fTomo-robot/Robotrace/(commit log)

2026-07-05 githubにあげる
    [DC-DC.kicad_sch, IMU.kicad_sch, MD.kicad_sch, Robotrace.kicad_pcb, Robotrace.kicad_sch]
2026-07-06 STM32のGPIOにUSB/UART/SPI/ADCの配線を追加、J11にラインセンサーを接続
    MCUのPA9-PA12(UART/USB), PB12-15(SPI)と、ADC用にPA0-7/PB0-1/PC0-3をラインセンサー13本+電圧監視1本に割り当て、J11コネクタのPin1-13にもラインセンサーの配線を追加。あわせてLineシートとCD74HC4067ライブラリを取り込み。
    Claude-Session: https://claude.ai/code/session_01781fWTRjWjmRZVNFFPgVZP
    [Line.kicad_sch, Robotrace.kicad_sch]
2026-07-06 モーターPWM/エンコーダ配線とST-LINK(SWD)配線を追加、J11欠落を修正
    PA8/PB8/PB9/PC9をPWM_A_L/B_L/A_R/B_Rに、PB4/PB5/PC6/PC7をEnc_A_L/B_L/A_R/B_Rに割り当てて配線。PA13/PA14/PB3をSWDIO/SWCLK/SWOラベルに接続しST-LINK経由のデバッグを可能に(NRSTは既存のRSTラベル経由で接続済みだったため対応不要)。
    また前回のトラブル対応(git checkout)で誤って失われていたJ11コネクタの復旧を反映(ユーザーがKiCad上で再配線)。
    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
    [Robotrace.kicad_sch]
2026-07-06 サイドセンサ・MDのEN・ビープ・LED・スイッチをMCUに配線
    PA15->LED_1, PB2->LED_2, PB6->LED_3, PB10->LED_4, PB11->SW_1, PC8->SW_2,
    PC10->MD_EN(2基のモータードライバ共通イネーブル), PC11->Side_L, PC12->Side_R, PC13->beep を割り当て。
    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
    [Robotrace.kicad_sch]
2026-07-06 ビープをPWM出力可能なPB11(TIM2_CH4)に変更、SW_1はPC13に移動
    PC13にはタイマー機能がないため、ビープをTIM2_CH4対応のPB11に付け替え、押し出されたSW_1をPC13(デジタル入力のみで良い)に割り当て直した。
    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
    [Robotrace.kicad_sch]
2026-07-06 水晶をFA-238V 12MHzに変更し、負荷容量C18/C19を15pFに修正
    Y1をSG-210STF(アクティブ発振器、案として検討したが不採用)ではなくFA-238V 12.000000MHz(パッシブ水晶、CL=10pF)に確定。
    それに伴い負荷容量として使うC18/C19を、誤って0.1uF(100nF)になっていたものから適正な15pFへ修正(2×CL-基板浮遊容量の目安で算出)。
    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
    [Robotrace.kicad_sch]
2026-07-06 DC-DCシートのENラベルをhierarchical_labelに修正し親シートと結線
    DC-DC.kicad_sch内のEN信号が通常のlabelのままで、親シート(Robotrace.kicad_sch)のシートピンと対応するhierarchical_labelになっておらず、ERC上結線されていなかった。IMU/MDシートの実装(hierarchical_label + shape input)に揃えて修正。
    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
    [DC-DC.kicad_sch]
2026-07-06 PWM/エンコーダ配線の復旧とIMU_INT1/INT2のMCU接続を追加
    ユーザーのKiCad上での保存時に、PWM_A_L/B_L/A_R/B_RとEnc_A_L/B_L/A_R/B_RのMCU側配線(PA8,PB8,PB9,PC9,PB4,PB5,PC6,PC7)が失われていたため復旧。
    あわせてIMU_INT1/INT2がMCUに未接続だった問題を修正(PD0->IMU_INT1, PD1->IMU_INT2)。既存のPA-PCポートが全て使用済みだったため、未使用のPD/PEポートがあることを確認しPD0/PD1を採用。
    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
    [Robotrace.kicad_sch]
2026-07-06 ピン配置を物理隣接性に基づき再編成(IMU/左右モーター群をクラスタ化)
    STM32F469VGT6のLQFP100パッケージの物理ピン番号を調べ、関連信号が基板上で隣接するよう再配置した。
    - IMUクラスタ: SPI(CS/CLK/MISO/MOSI = PB12-15, 物理ピン46-49)の直後にINT1/INT2(PD8/PD9, ピン50-51)を配置し、6本が連続。
    - 左モーター群(TIM8): Enc_A_L/Enc_B_L/PWM_A_L/PWM_B_L = PC6/PC7/PC8/PC9(ピン66-69)で連続。エンコーダをCH1/CH2、PWMをCH3/CH4に割当。
    - 右モーター群(TIM4): Enc_A_R/Enc_B_R/PWM_A_R/PWM_B_R = PB6/PB7/PB8/PB9(ピン95・96・98・99)で連続。
    - 上記により押し出されたLED_3->PB4、SW_2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
    [Robotrace.kicad_sch]
2026-07-06 ピン配置見直し
2026-07-07 回路図終わり
    [DC-DC.kicad_sch, IMU.kicad_sch, MD.kicad_sch, Robotrace.kicad_pcb, Robotrace.kicad_sch]
2026-07-07 配線終わり
    [DC-DC.kicad_sch, LineBoard.kicad_pcb, LineBoard.kicad_sch, Robotrace.kicad_pcb, Robotrace.kicad_sch]
2026-07-07 サイドセンサプルアップ追加
    [LineBoard.kicad_pcb, LineBoard.kicad_sch, Robotrace.kicad_pcb, Robotrace.kicad_sch]
2026-07-07 メイン基板完成
    [LineBoard.kicad_pcb, LineBoard.kicad_sch, Robotrace.kicad_pcb, Robotrace.kicad_sch]
2026-07-07 基板完成
    [LineBoard.kicad_pcb, LineBoard.kicad_sch, Robotrace.kicad_pcb, Robotrace.kicad_sch, bom.csv, designators.csv, positions.csv]
